franzpl/StableGrid/doc_pictures/optocoupler.png

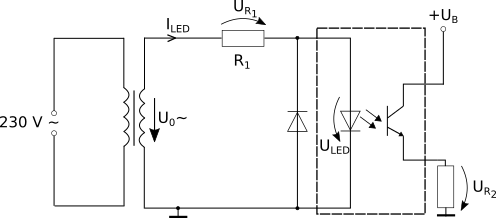
doc_pictures/optocoupler.png
