franzpl/StableGrid/doc_pictures/schmitt_trigger.png

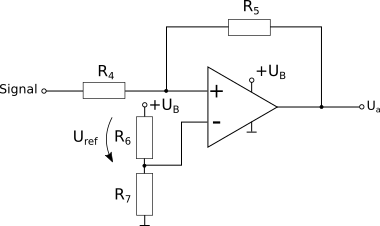
doc_pictures/schmitt_trigger.png
