franzpl/StableGrid/doc_pictures/voltage_divider.png

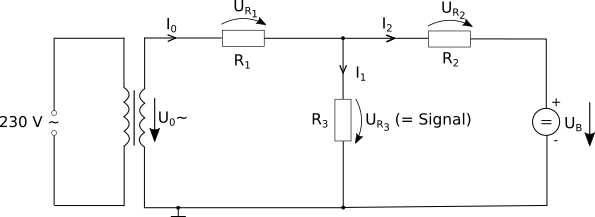
doc_pictures/voltage_divider.png
