franzpl/StableGrid/circuits/stable_grid_optocoupler.pdf

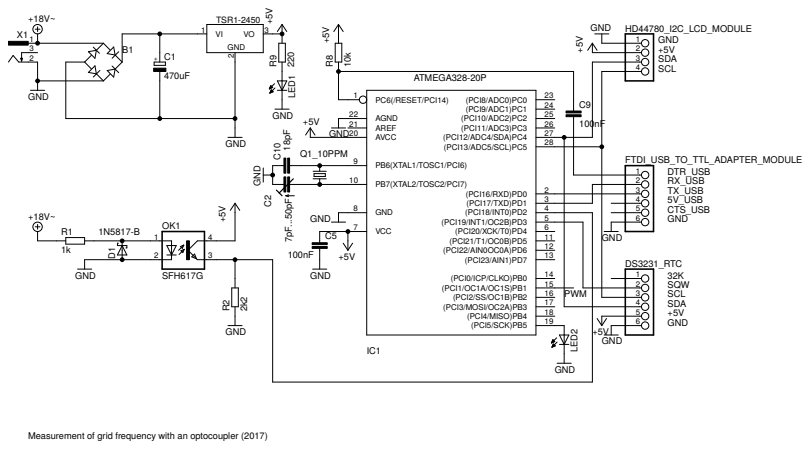
[picture p9: page 1]

Measurement of grid frequency with an optocoupler (2017)
