franzpl/StableGrid/circuits/stable_grid_schmitt_trigger.pdf

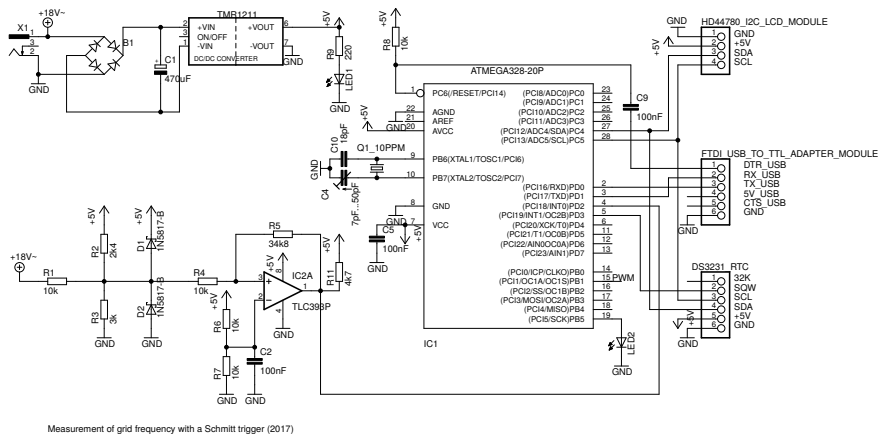
[picture p10: page 1]

Measurement of grid frequency with a Schmitt trigger (2017)
