franzpl/StableGrid/eagle_files/stable_grid_optocoupler.sch

## EAGLE design eagle_files/stable_grid_optocoupler.sch (2017-09-08)

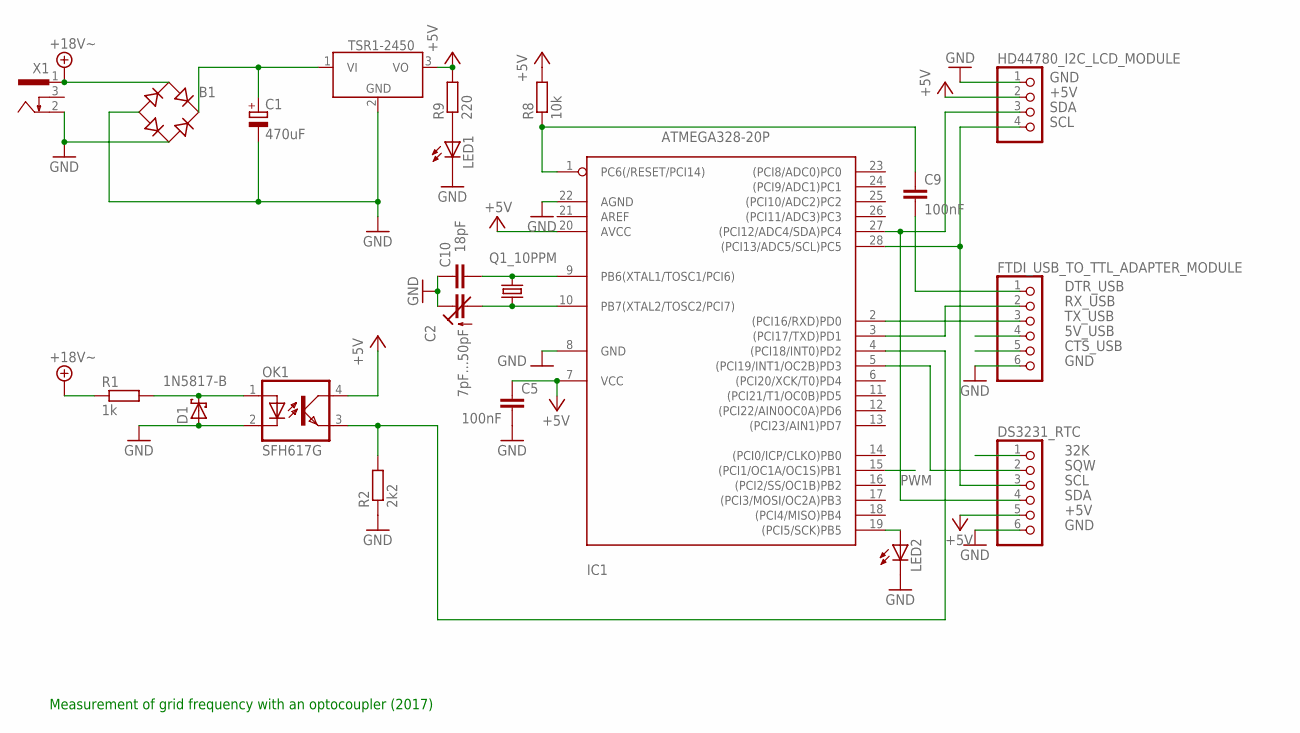
[picture p11: schematic stable_grid_optocoupler.sch]

Parts:
B1: B-DIL
C1: 470uF; 085CS_1AR
C2: 7pF...50pF; CTRIM808-BC
C5, C9: 100nF; C025-024X044
C10: 18pF; C025-024X044
D1: 1N5817-B; DO41-7.6
DS3231_RTC: PINHD-1X6; 1X06
FTDI_USB_TO_TTL_ADAPTER_MODULE: PINHD-1X6; 1X06
HD44780_I2C_LCD_MODULE: PINHD-1X4; 1X04
IC1: ATMEGA328-20P; DIL28-3
LED1: LAP4-BOTTOM; P47F-BOTTOM
LED2: LYP4-BOTTOM; P47F-BOTTOM
OK1: SFH617G; DIL04B
Q1_10PPM: CRYSTALHC49S; HC49/S
R1: 1k; M0805
R2: 2k2; M0805
R8: 10k; M0805
R9: 220; M0805
TSR1-2450: TSR_1-24_; TSR-1
X1: 9V; 733980-62

Connections:
5V_USB: FTDI_USB_TO_TTL_ADAPTER_MODULE.4
32K: DS3231_RTC.1
+: B1.+, C1.+, TSR1-2450.1 (VI)
+5V: C5.1, DS3231_RTC.5, HD44780_I2C_LCD_MODULE.2, IC1.7 (VCC), IC1.20 (AVCC), OK1.4 (COL), R8.2, R9.2, TSR1-2450.3 (VO)
+18V: B1.AC1, R1.1, X1.1
CTS_USB: FTDI_USB_TO_TTL_ADAPTER_MODULE.5
DTR_USB: C9.2, FTDI_USB_TO_TTL_ADAPTER_MODULE.1
GND: B1.-, B1.AC2, C1.-, C2.1 (E), C5.2, C10.1, D1.A, DS3231_RTC.6, FTDI_USB_TO_TTL_ADAPTER_MODULE.6, HD44780_I2C_LCD_MODULE.1, IC1.8 (GND), IC1.22 (AGND), LED1.C, LED2.C, OK1.2 (C), R2.1, TSR1-2450.2 (GND), X1.2
unnamed: IC1.19 ((PCI5/SCK)PB5), LED2.A
unnamed: D1.C, OK1.1 (A), R1.2
unnamed: C10.2, IC1.9 (PB6(XTAL1/TOSC1/PCI6)), Q1_10PPM.2
unnamed: LED1.A, R9.1
unnamed: C2.2 (A), IC1.10 (PB7(XTAL2/TOSC2/PCI7)), Q1_10PPM.1
unnamed: IC1.4 ((PCI18/INT0)PD2), OK1.3 (EMIT), R2.2
unnamed: C9.1, IC1.1 (PC6(/RESET/PCI14)), R8.1
PWM: IC1.15 ((PCI1/OC1A/OC1S)PB1)
RX_USB: FTDI_USB_TO_TTL_ADAPTER_MODULE.2, IC1.3 ((PCI17/TXD)PD1)
SCL: DS3231_RTC.3, HD44780_I2C_LCD_MODULE.4, IC1.28 ((PCI13/ADC5/SCL)PC5)
SDA: DS3231_RTC.4, HD44780_I2C_LCD_MODULE.3, IC1.27 ((PCI12/ADC4/SDA)PC4)
SQW: DS3231_RTC.2, IC1.5 ((PCI19/INT1/OC2B)PD3)
TX_USB: FTDI_USB_TO_TTL_ADAPTER_MODULE.3, IC1.2 ((PCI16/RXD)PD0)

Notes on the sheet:
Measurement of grid frequency with an optocoupler (2017)
