franzpl/StableGrid/eagle_files/stable_grid_schmitt_trigger.sch

## EAGLE design eagle_files/stable_grid_schmitt_trigger.sch (2017-09-08)

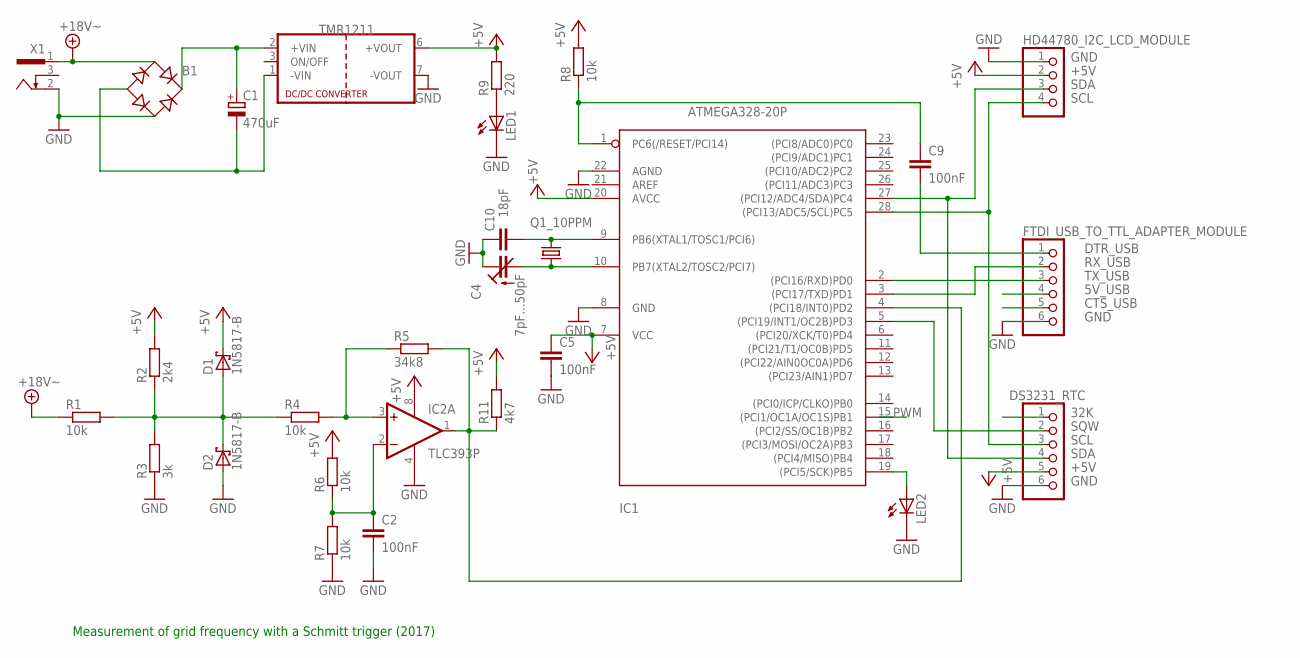
[picture p12: schematic stable_grid_schmitt_trigger.sch]

Parts:
B1: B-DIL
C1: 470uF; 085CS_1AR
C2, C5, C9: 100nF; C025-024X044
C4: 7pF...50pF; CTRIM808-BC
C10: 18pF; C025-024X044
D1, D2: 1N5817-B; DO41-7.6
DS3231_RTC: PINHD-1X6; 1X06
FTDI_USB_TO_TTL_ADAPTER_MODULE: PINHD-1X6; 1X06
HD44780_I2C_LCD_MODULE: PINHD-1X4; 1X04
IC1: ATMEGA328-20P; DIL28-3
IC2: TLC393P; DIL08
LED1, LED2: LAP4-BOTTOM; P47F-BOTTOM
Q1_10PPM: CRYSTALHC49S; HC49/S
R1, R4, R6, R7, R8: 10k; M0805
R2: 2k4; M0805
R3: 3k; M0805
R5: 34k8; M0805
R9: 220; M0805
R11: 4k7; M0805
SPS1: TMR1211; TRACO_SIP-8
X1: 733980-62

Connections:
5V_USB: FTDI_USB_TO_TTL_ADAPTER_MODULE.4
32K: DS3231_RTC.1
+5V: C5.1, D1.C, DS3231_RTC.5, HD44780_I2C_LCD_MODULE.2, IC1.7 (VCC), IC1.20 (AVCC), IC2.8 (V+), R2.2, R6.2, R8.2, R9.2, R11.2, SPS1.6 (+VOUT)
+18V: B1.AC1, R1.1, X1.1
CTS_USB: FTDI_USB_TO_TTL_ADAPTER_MODULE.5
DTR_USB: C9.2, FTDI_USB_TO_TTL_ADAPTER_MODULE.1
GND: B1.AC2, C2.2, C4.1 (E), C5.2, C10.1, D2.A, DS3231_RTC.6, FTDI_USB_TO_TTL_ADAPTER_MODULE.6, HD44780_I2C_LCD_MODULE.1, IC1.8 (GND), IC1.22 (AGND), IC2.4 (V-), LED1.C, LED2.C, R3.1, R7.1, SPS1.7 (-VOUT), X1.2
unnamed: B1.+, C1.+, SPS1.2 (+VIN)
unnamed: IC2.3 (+IN), R4.2, R5.1
unnamed: D1.A, D2.C, R1.2, R2.1, R3.2, R4.1
unnamed: C10.2, IC1.9 (PB6(XTAL1/TOSC1/PCI6)), Q1_10PPM.2
unnamed: C2.1, IC2.2 (-IN), R6.1, R7.2
unnamed: IC1.19 ((PCI5/SCK)PB5), LED2.A
unnamed: LED1.A, R9.1
unnamed: C4.2 (A), IC1.10 (PB7(XTAL2/TOSC2/PCI7)), Q1_10PPM.1
unnamed: IC1.4 ((PCI18/INT0)PD2), IC2.1 (OUT), R5.2, R11.1
unnamed: C9.1, IC1.1 (PC6(/RESET/PCI14)), R8.1
unnamed: B1.-, C1.-, SPS1.1 (-VIN)
RX_USB: FTDI_USB_TO_TTL_ADAPTER_MODULE.2, IC1.3 ((PCI17/TXD)PD1)
SCL: DS3231_RTC.3, HD44780_I2C_LCD_MODULE.4, IC1.28 ((PCI13/ADC5/SCL)PC5)
SDA: DS3231_RTC.4, HD44780_I2C_LCD_MODULE.3, IC1.27 ((PCI12/ADC4/SDA)PC4)
SQW: DS3231_RTC.2, IC1.5 ((PCI19/INT1/OC2B)PD3)
TX_USB: FTDI_USB_TO_TTL_ADAPTER_MODULE.3, IC1.2 ((PCI16/RXD)PD0)

Notes on the sheet:
Measurement of grid frequency with a Schmitt trigger (2017)
