franzpl/StableGrid/arduino_scripts/FreqMeasurementdSPACE/FreqMeasurementdSPACE.ino

// Mains frequency measurement (Germany 50 Hz)
// measurement of fluctuations in mains frequency
// interrupt handler: mains frequency

#include <LiquidCrystal_I2C.h>


volatile unsigned long pulseCounter = 0; 
volatile unsigned long currentMicros;
volatile unsigned long previousMicros = 0;
volatile unsigned long duration = 0;

unsigned long _duration;
unsigned long _pulseCounter;
 // determine the time of averaging length
unsigned long measuringTime =  1000; // ms
unsigned long currentRuntime = 0;
unsigned long previousRuntime = 0; 

int overflow_state = 0; 


float freq; 

LiquidCrystal_I2C lcd(0x27, 20, 4);

void setup() {

Serial.begin(115200);
setupPWM16();
lcd.begin();
lcd.print("Mains Frequency: ");
lcd.setCursor(7, 1);
lcd.print("Hz");


attachInterrupt(0, mains_freq_handler, RISING); // Pin 2 

}

void loop() {

 // number of milliseconds since the 
 // Arduino board began running the current program
currentRuntime = millis();

if (currentRuntime - previousRuntime >= measuringTime) {


  previousRuntime = currentRuntime;
  _duration = duration;
  _pulseCounter = pulseCounter;
  duration = 0;
  pulseCounter = 0;

  if(!overflow_state) {
  freq = 1e6 * _pulseCounter / (float(_duration)); 

  if(freq == 50.000) {
    analogWrite16(9, 32768);
  }

  else if(freq > 50.000) {
    analogWrite16(9, 32768 + 50 * (freq - 50.000));
  }
  else if(freq < 50.000) {
    analogWrite16(9, 32768 - 50 * (50.000 - freq));
  }
  
  
  Serial.println(freq, 3);

  lcd.setCursor(0, 1);
  lcd.print(freq, 3); }
}
  else {
    overflow_state = 0; }
  
}

void mains_freq_handler() {

  if (previousMicros > micros()) {
  overflow_state = 1;
 }

 
  currentMicros = micros();
  duration += currentMicros - previousMicros;
  previousMicros = currentMicros;
  pulseCounter++; 
 
  
}

void setupPWM16() {
    DDRB |= _BV(PB1) | _BV(PB2);        /* set pins as outputs */
    TCCR1A = _BV(COM1A1) | _BV(COM1B1)  /* non-inverting PWM */
        | _BV(WGM11);                   /* mode 14: fast PWM, TOP=ICR1 */
    TCCR1B = _BV(WGM13) | _BV(WGM12)
        | _BV(CS10);                    /* no prescaling */
    ICR1 = 0xffff;                      /* TOP counter value */
}

/* 16-bit version of analogWrite(). Works only on pins 9 and 10. */
void analogWrite16(uint8_t pin, uint16_t val)
{

     OCR1A = val;

}
