franzpl/StableGrid/(commit log)

2017-06-13 add circuits in png format
2017-09-08 first add
    [stable_grid_optocoupler.sch, stable_grid_schmitt_trigger.sch]
2017-09-08 add to folder arduino_scripts
